VSElec/SolderDuino/DOC/SolderDuinoPCB (2).JPG

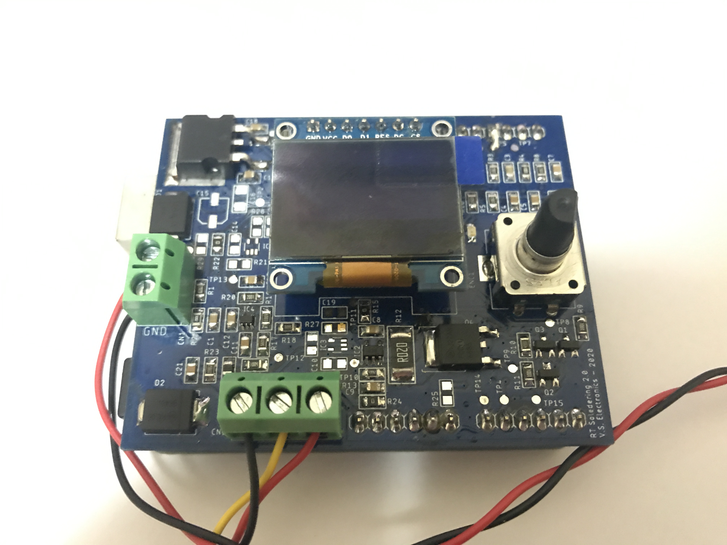
DOC/SolderDuinoPCB (2).JPG
