VSElec/SolderDuino/DOC/SolderDuinoPCB (3).JPG

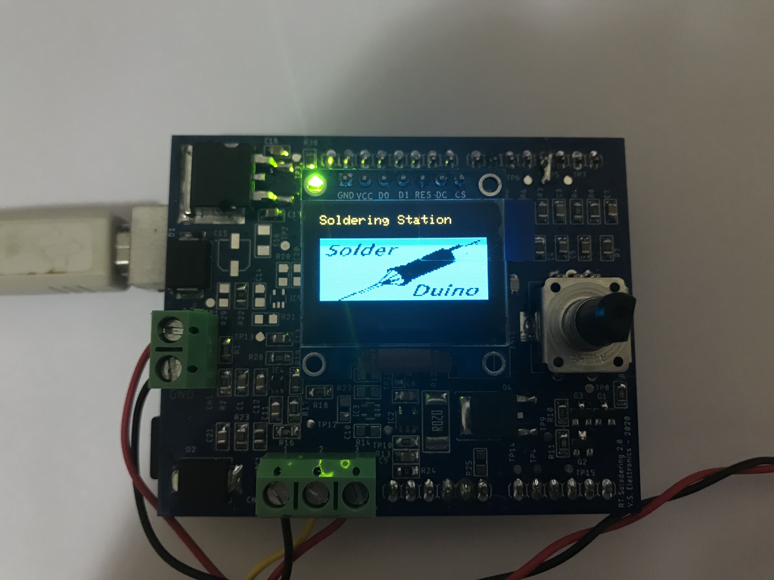
DOC/SolderDuinoPCB (3).JPG
