VSElec/SolderDuino/DOC/SolderDuinoPCB (4).JPG

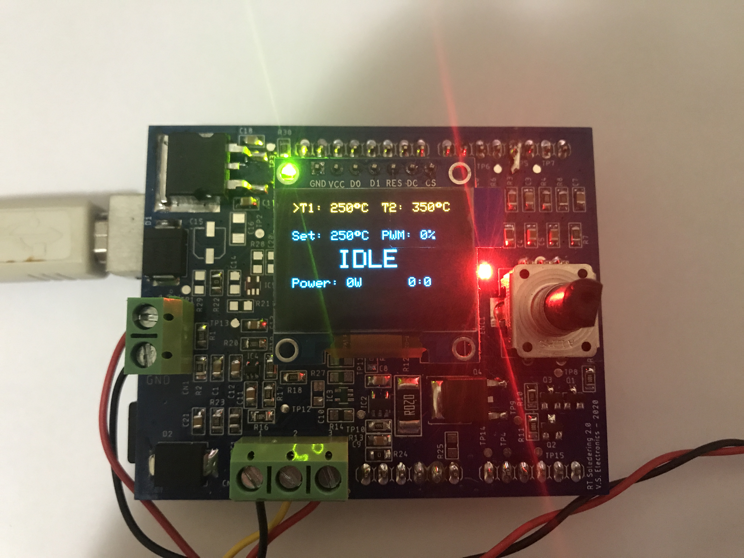
DOC/SolderDuinoPCB (4).JPG
