VSElec/SolderDuino/DOC/SolderDuinoPCB (5).JPG

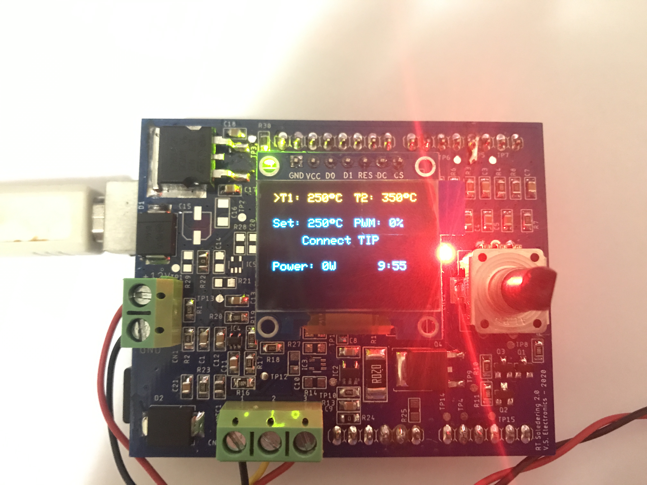
DOC/SolderDuinoPCB (5).JPG
