VSElec/SolderDuino/DOC/SolderDuinoPCB (6).JPG

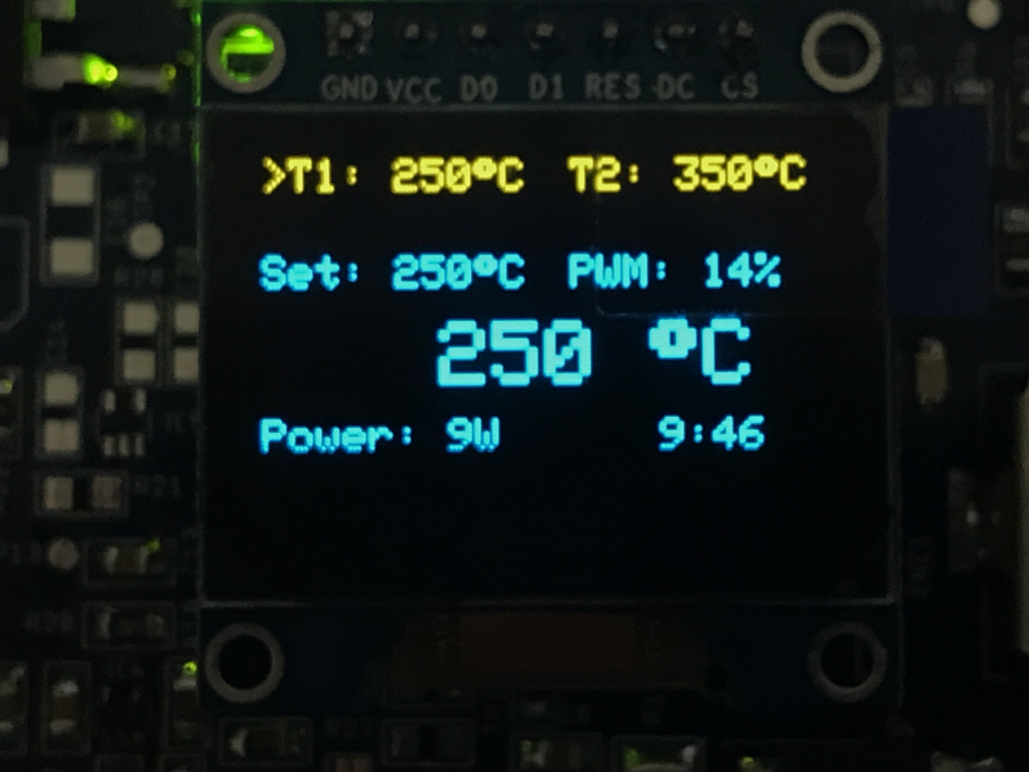
DOC/SolderDuinoPCB (6).JPG
