VSElec/SolderDuino/DOC/SolderDuinoPCB (7).JPG

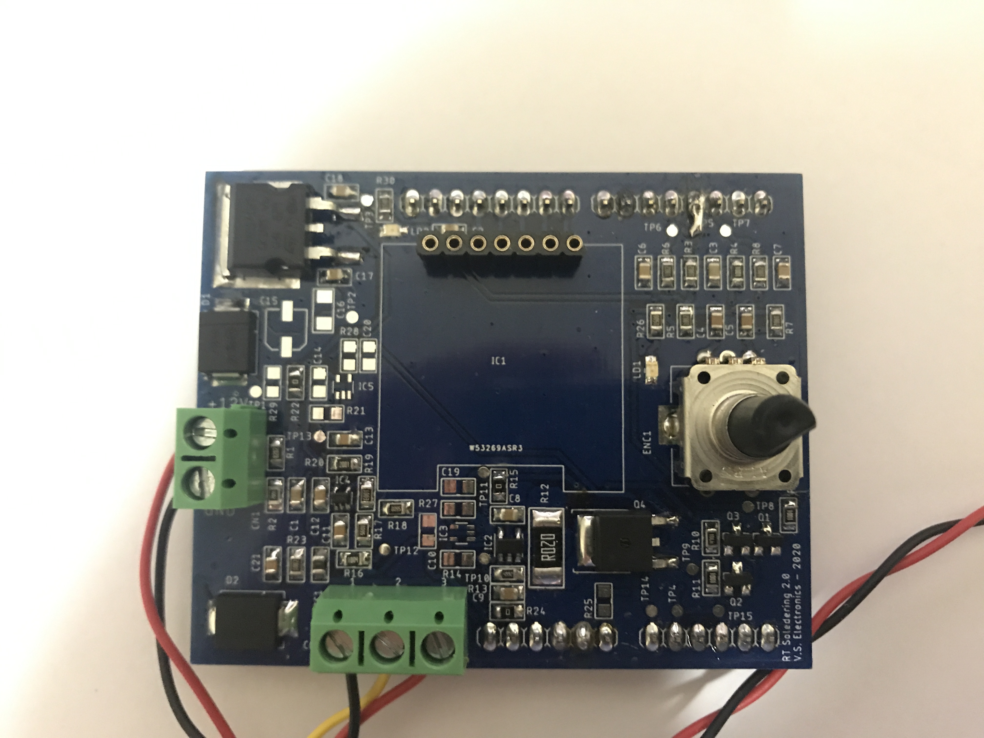
DOC/SolderDuinoPCB (7).JPG
