VSElec/SolderDuino/DOC/SolderDuinoPCB (8).JPG

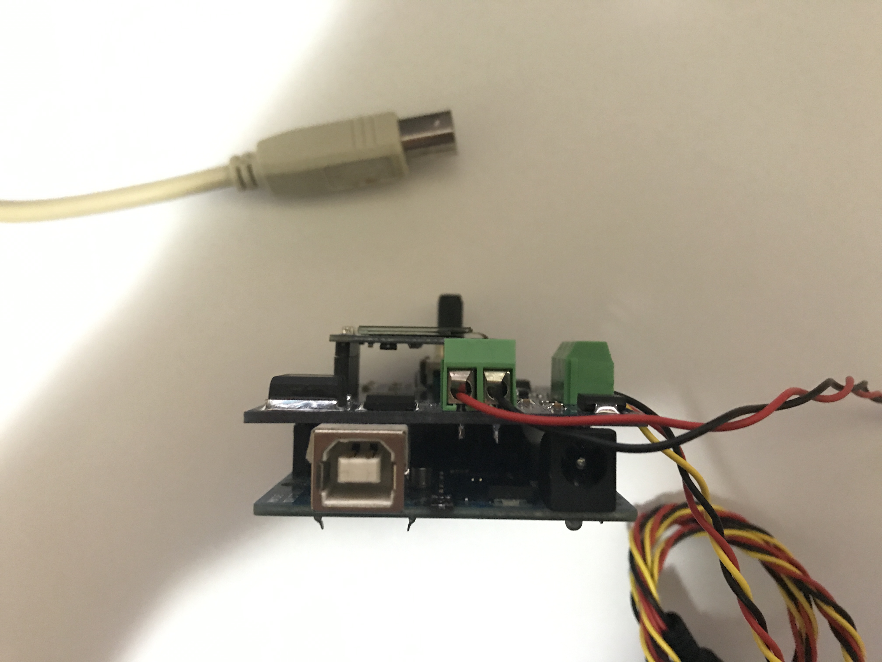
DOC/SolderDuinoPCB (8).JPG
