VSElec/SolderDuino/DOC/SolderDuinoPCB (9).JPG

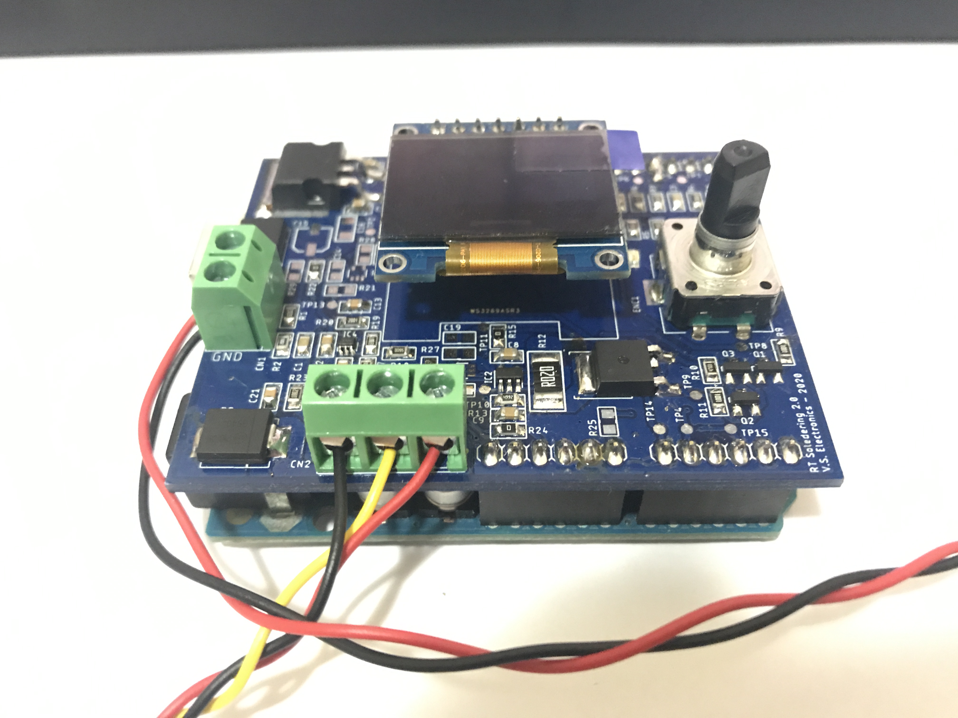
DOC/SolderDuinoPCB (9).JPG
