VSElec/SolderDuino/SCH/v1.0/SolderDuinoSCH_09062020.pdf

A

A

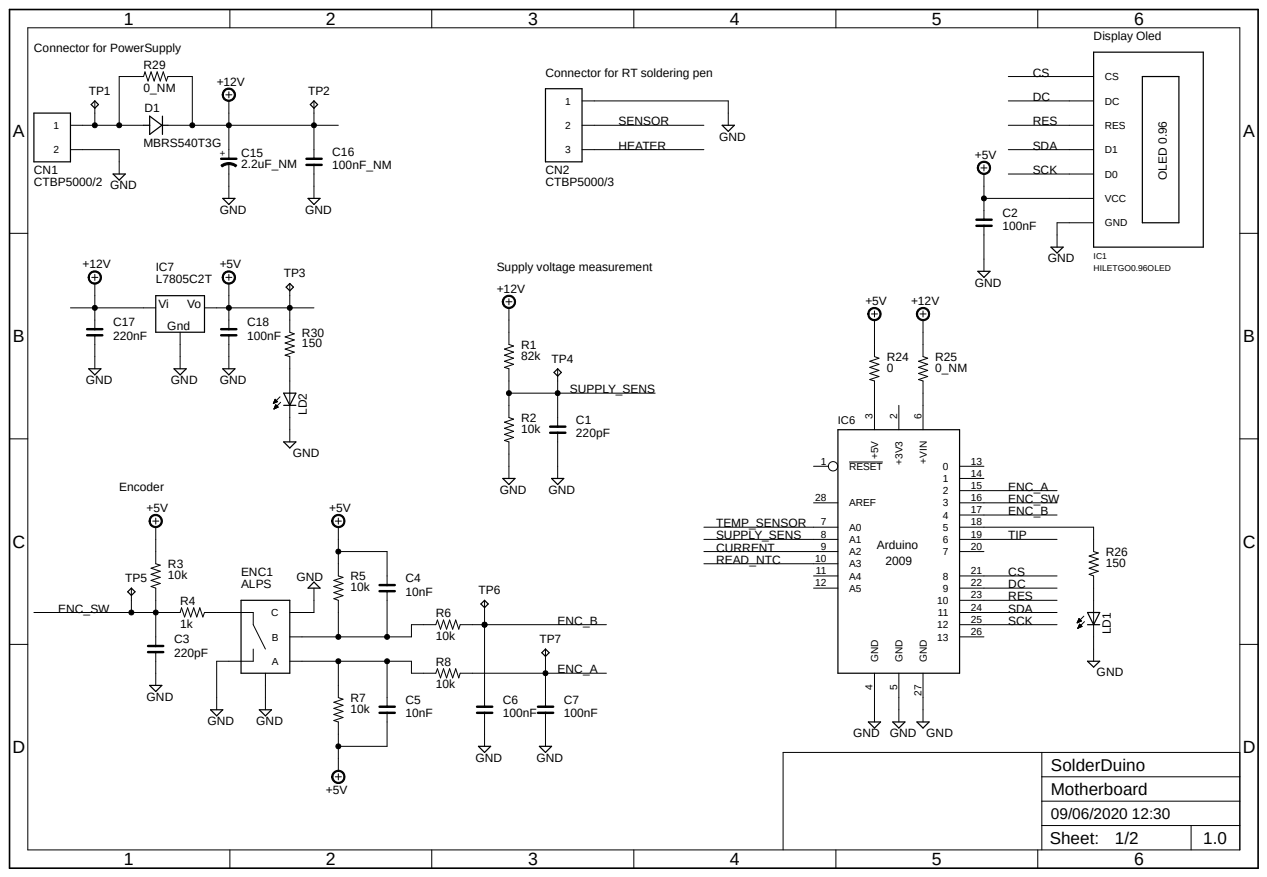
[picture p25: page 1]

Connector for RT soldering pen

A

A

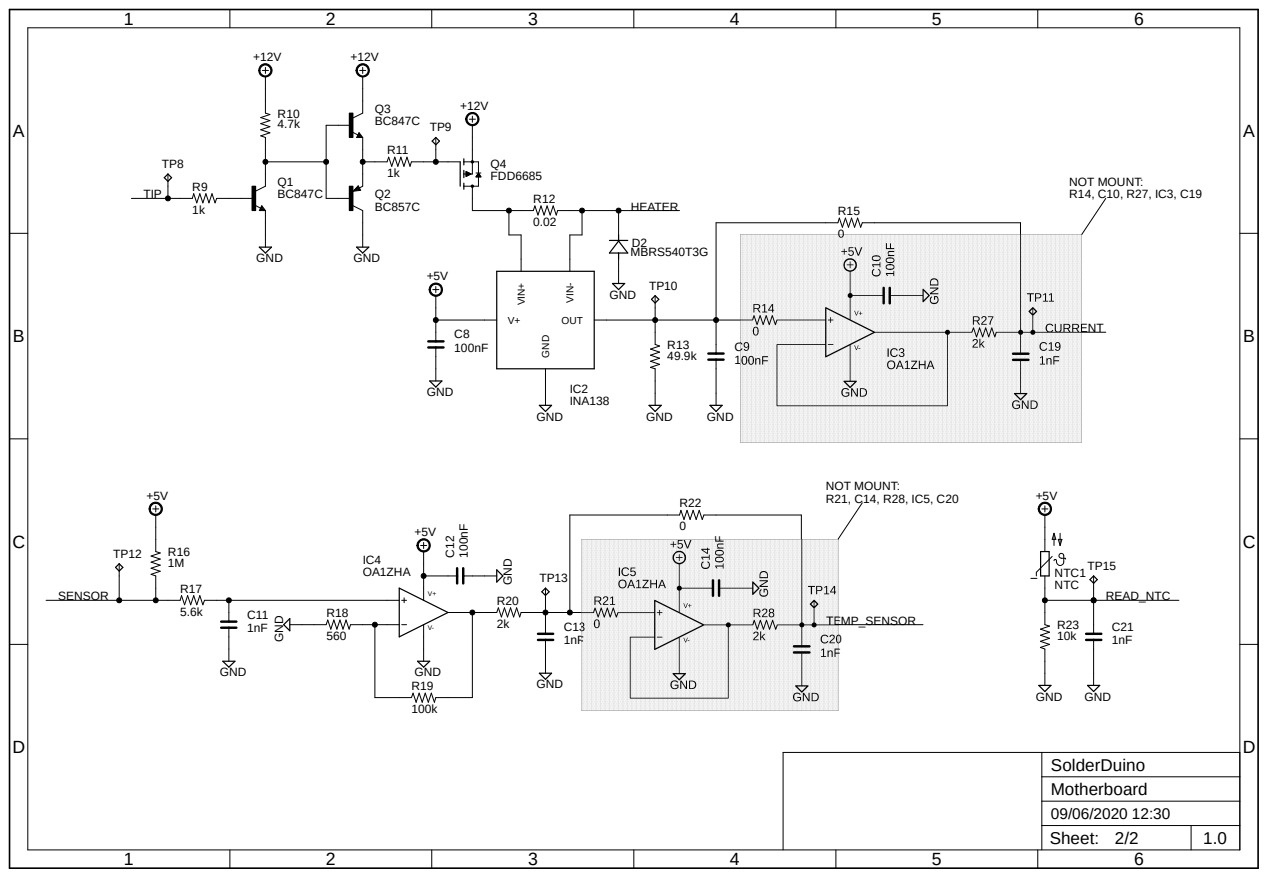
[picture p26: page 2]
