VSElec/SolderDuino/Firmware/Logo.h

/*  Logo soldering station
    File: Logo.h
    Ver: 1.0
    Created on: 06/06/2020
    Author: Stefano Valfrè
*/

/*
  Site used to convert images:
  https://diyusthad.com/image2cpp
*/
#ifndef _LOGO_H
#define _LOGO_H

// 'Logo2', 128x55px
const unsigned char myLogo [] PROGMEM = {
  0xff, 0xff, 0xff, 0xff, 0xff, 0xff, 0xff, 0xff, 0xff, 0xff, 0xff, 0xff, 0xff, 0xff, 0xff, 0xff,
  0xff, 0xff, 0xff, 0xff, 0xff, 0xff, 0xff, 0xff, 0xff, 0xff, 0xff, 0xff, 0xff, 0xff, 0xff, 0xff,
  0xff, 0xff, 0xff, 0xff, 0xff, 0xff, 0xff, 0xff, 0xff, 0xff, 0xff, 0xff, 0xff, 0xff, 0xff, 0x9f,
  0xff, 0xff, 0xff, 0xff, 0xff, 0xff, 0xff, 0xff, 0xff, 0xff, 0xff, 0xff, 0xff, 0xff, 0xfc, 0x7f,
  0xff, 0xff, 0xff, 0xfc, 0xff, 0x3f, 0xff, 0xff, 0xff, 0xff, 0xff, 0xff, 0xff, 0xff, 0xf2, 0xff,
  0xff, 0x81, 0xff, 0xf9, 0xff, 0x3f, 0xff, 0xff, 0xff, 0xff, 0xff, 0xff, 0xff, 0xdf, 0x87, 0x7f,
  0xff, 0x3f, 0xff, 0xf9, 0xfe, 0x3f, 0xff, 0xff, 0xff, 0xff, 0xff, 0xff, 0xff, 0x02, 0x7f, 0xff,
  0xfe, 0x7f, 0xc1, 0xf3, 0xc0, 0x7c, 0x3c, 0x8f, 0xff, 0xff, 0xff, 0xff, 0xf8, 0x0f, 0xff, 0xff,
  0xfe, 0x1f, 0x9c, 0xe3, 0x9c, 0xf3, 0x3c, 0x7f, 0xff, 0xff, 0xff, 0xf9, 0xe0, 0x3f, 0xff, 0xff,
  0xff, 0x87, 0x3c, 0xe7, 0x3c, 0xe7, 0x39, 0xff, 0xff, 0xff, 0xff, 0xe0, 0x01, 0xff, 0xff, 0xff,
  0xff, 0xe6, 0x7c, 0xc6, 0x79, 0xc0, 0x39, 0xff, 0xff, 0xff, 0xff, 0x00, 0x07, 0xff, 0xff, 0xff,
  0xff, 0xc6, 0x79, 0xce, 0x79, 0xcf, 0xf3, 0xff, 0xff, 0xff, 0xfc, 0x00, 0x07, 0xff, 0xff, 0xff,
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
  0xff, 0xff, 0xff, 0xff, 0xf3, 0x7f, 0xff, 0xff, 0xff, 0xcf, 0x8f, 0xff, 0xff, 0xff, 0xff, 0xff,
  0xff, 0xff, 0xff, 0xff, 0xdd, 0xff, 0xff, 0xff, 0xff, 0x9f, 0x8c, 0x73, 0x9e, 0x03, 0xc4, 0x7f,
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
};

#endif
