VSElec/SolderDuino/Firmware/Timer.h

/*  Library for Time Out
 *  File: Timer.h
 *  Ver: 1.0
 *  Created on: 06/06/2020
 *  Author: Stefano Valfrè
 */
 
#ifndef _TIMER_H
#define _TIMER_H

#include <Arduino.h>
#include "E2prom.h"

void StartTimeOut(void);
void ResetTimer(void);

#endif
